Gernreich/kalimba/step/kalimba-septa-box.step

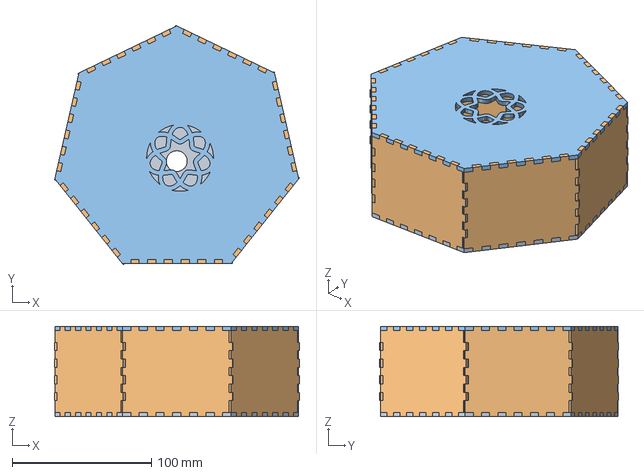
[picture p1: CAD file, 2026-11-09]
step/kalimba-septa-box.step
176.2 x 172.2 x 65.0 mm
