Gernreich/kalimba/(commit log)

2026-08-08 kalimba: a seven-sided body and its septafoil sound hole
    Two cut files with a writeup and its generated page. Every dimension in the
    docs was measured out of the SVGs with Inkscape's query interface rather than
    assumed: seven 79.3 x 65.3mm sides, two ~176mm heptagonal faces, and a 30mm
    radius rosette.
    Documented rather than silently fixed: the sheet carries boxes.py's 100mm
    reference bar, whose rectangle is drawn in the same black as the seven side
    panels -- so a colour-keyed job cutting black cuts it too. And the standalone
    sound hole is an earlier render that still carries the retired #d8c9a8 preview
    fill and predates the rim continuations, though its cut path data is
    byte-for-byte identi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
2026-08-08 kalimba: follow the reworked cut sheet
    The sheet was updated and the standalone sound-hole file removed. Rebuilt the
    preview from the current file and corrected the writeup to match what is now
    there, all measured rather than carried over:
    - sheet 583 x 270mm -> 495 x 279mm
    - the boxes.py reference bar is gone, so the warning about it not being a
    part went with it
    - both faces are now black; the purple face outline is gone
    - a 15mm round hole has appeared in the plain face
    - the rosette is 48.6mm across, not 60mm, with a 50.1mm engrave band
    The README still described the deleted sound-hole file, the reference bar and
    the 583mm sheet; rewritten. Still a septafoil - counted sev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
2026-08-08 kalimba: three reinforcing trapezoids, and the cut order
    The sheet gained three 133.3 x 37.3mm trapezoids in purple #ff00ff. They glue
    under the top sheet of the heptagon to stiffen it and are optional, so the
    writeup says so plainly -- skip the purple stage and the build still stands.
    Worth having, given that face has the rosette cut out of it.
    Both documents now give the laser order rather than just naming the colours:
    blue engraves first, then red, purple and black cut, outlines last so nothing
    moves once a cut frees it.
    Also checked, since several panels sit right on the sheet edge: nothing hangs
    off. The 0.07mm the bounding box reports past the top and bottom is exactly
    half the 0.14m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
2026-08-08 docs: name the stock — 3mm Baltic birch plywood
    Every build in these repositories is cut from it, and saying so retires a
    caveat that appeared in all seven: "material and thickness are yours, nothing
    has been validated against cut stock".
    Two places where the thickness was load-bearing and unknown:
    kalimba — the writeup said the sheet "does not record which thickness it
    assumed" for its finger joints. It is 3mm, so the joints are
    sized for 3mm, and substituting means regenerating them.
    slapstick— the laminates now have real numbers: three paddle blanks make a
    9mm slat, five handle strips make a 15mm handle.
    Where the void-free core actuall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
2026-08-08 red becomes green, purple becomes orange
    Colour is the cut order in all seven of these repositories, and they disagreed
    with each other about which colour meant what. Red was a cut here and in two
    others, and an engrave in slapstick; magenta was a cut stage here and a
    different cut stage there. Anyone working across two of these files was one
    habit away from cutting the wrong thing at the wrong time.
    One sequence now: blue engraves, then green, orange, cyan, black, black always
    the cut that frees the part, violet always skip. This sheet keeps its four
    stages and its order exactly -- engrave the interlace, cut the rosette and the
    round hole, cut the optional trapezoids, then the outlines. On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
2026-08-08 the previews darken three inks, and the pages now say so
    make-preview.py darkens green, orange and cyan because at full strength they
    fall to 1.28:1, 2.35:1 and 1.17:1 against the cream ground -- all under the 3:1
    graphics minimum, so the cut order could not be read off the picture. That was
    documented in lasermade-tools and nowhere a reader would look.
    Two pages went further and said the opposite. Slapstick: "the cut-order colours
    are untouched." Kalimba: "Colours, geometry and sheet position are untouched."
    Both were true when written and stopped being true when the palette was
    aligned, and neither the audit script nor anything reading markup could see it
    -- a screenshot of the published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
2026-08-08 the writeup link moves above the gallery
    It sat just below the pictures, which on these READMEs means below a table of
    five thumbnails and a caption -- past the fold on a phone, and past the fold on
    GitHub at anything under a tall window. The link to the full build guide was the
    one thing a reader arriving from the video most likely wants, and it was the one
    thing they had to scroll for.
    It now sits directly under the opening description, above the first picture, in
    all seven repositories. High enough to be seen without scrolling, low enough to
    have the sentence of context that says what the writeup is about.
    Nothing else moved: the caption, the LaserMadeMusic credit and the ZIP link keep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
2026-09-04 Ignore xTool project files
    *.xs is the laser's working format: written beside the cut files when a sheet
    is set up to run, large, binary, and regenerated from the SVG every time. The
    SVG is the source. bore-ribbon got this line on 2026-09-03 when two turned up
    there; this is the rest of them, so the next one is caught wherever it lands.
    No repository here tracks a .xs, so nothing is un-tracked by adding it.
    Claude-Session: https://claude.ai/code/session_01VzXwLADAvkvDDCs1E3NrBd
2026-09-07 Stop publishing "Read the writeup" on the writeup itself
    The link points at the page you are already reading. md2html.py's
    <!-- readme-only --> marker drops the paragraph after it from the generated page
    while GitHub renders the comment as nothing, so the README keeps the link where
    it is useful. living-hinge already did this; this repository did not.
    The shipped page happened not to carry the link only because it predated it:
    doc-audit reported "page is current with the markdown" as failing here. So this
    also republishes the page against the current README, which brings across every
    README edit made since the page was last built.
    Audit: 17 passed, 0 failed.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
2026-09-07 One measuring convention in the size table, and a route to other stock
    The table measured the black and blue rows to the outer edge of the drawn
    stroke and the orange row to the path. Every row is now the path, which is
    what the laser follows and what the section's own note about the 0.07mm
    overhang already implies. Faces 175.6 x 171.6 and 175.6 x 171.2, sides
    79.1 x 65.1, blue band 50.0, rosette 48.5 across; the orange trapezoids were
    already right and did not move. Said in the text which convention it is.
    "The joints have to be regenerated rather than merely scaled" named no tool
    and the repo ships only the SVG. boxes.py's RegularBox generator does it --
    verified that --n 7 --thickness 3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
2026-09-24 Rebuild with md2html's theme-button fix for narrow screens
    Below 900px the theme button no longer covers the contents list.
2026-10-13 Previews on a white ground (#ffffff), not cream
    Only the ground rect changed; make-preview.py now draws white.
2026-10-13 The hero sheet scales to the page instead of a fixed 620px
    At 400px it pushed the page sideways on a phone. Measured after: the page is
    400px wide in a 400px frame.
2026-10-14 A 3D viewer, assembled from the cut files by viewer.py; .repro claims every drawing and page
2026-10-14 3D viewer: note folds away, theme follows the hub's button
2026-10-22 Link back to all projects at the top of the README and the page
    The rest of the build files now points at lasermademusic.html, where the
    instruments moved when the root page became a directory.
2026-10-23 3D view: fitted to its frame, and framed bare at the top of the page
2026-11-07 Call lasermade-tools' Rust programs, not its Python scripts
    The tools became Rust on 2026-11-07: target/release/<name> in lasermade-tools
    (cargo build --release there) replaces python3 <name>.py, in commands,
    manifests and prose. Pages rebuilt; no generated file changes otherwise.
2026-11-07 The 3D viewer is Rust: viewer.rs on lasermade-tools' turn3d module
    Same page byte for byte, apart from its written-by line naming viewer.rs.
2026-11-08 STEP files of the 3D view, for a CAD program
    One file per design in step/, one solid body per part, written from the
    3D page by lasermade-tools step-export and checked by .repro. Every file
    opens in SolidCraft with every body closed and no warnings.
2026-11-09 Draw the body from parameters: kalimba.rs writes the sheet and a SolidCraft design
    The box is Boxes.py's RegularBox worked out again from its rules (radius 90
    outside, 7 sides, 65 high, fingers and spaces two plies, 0.14 mm kerf):
    every outline lies on Boxes' own to within 0.05 mm². The rosette is
    knotwork-soundholes' 2-lead knot with a bight per side, read from its cut
    file and placed regularly (48 mm, a bight at every corner, 5.5 mm off
    centre towards one) where the drawn one was hand-scaled and skewed. The
    stiffeners are slices of the inside heptagon, 36.4 mm deep, corners cut
    back 4.7 mm. The design is the assembled box, one body per part, every
    point written from the parameters; SolidC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
2026-11-09 Kalimba design: finger counts follow the sizes
    nb and nl were the defaults' 6 and 4, read-only, so a longer box only grew
    the plain leftover at each end. Now they are floor(side0/(fw + sw)) and
    floor(wall_l/(fw + sw)), and each wall is its plain body with one finger
    top and bottom and one corner finger or slot per end, patterned that many
    times; each face is the plain heptagon with one patterned slot per edge.
    Identical to the old design at the defaults; at radius 200 / height 150
    (14 and 12 fingers) every volume within 4e-7 of the generator's sheet.
